ebartz/esp8266-rfid-sonos/img/001.jpg

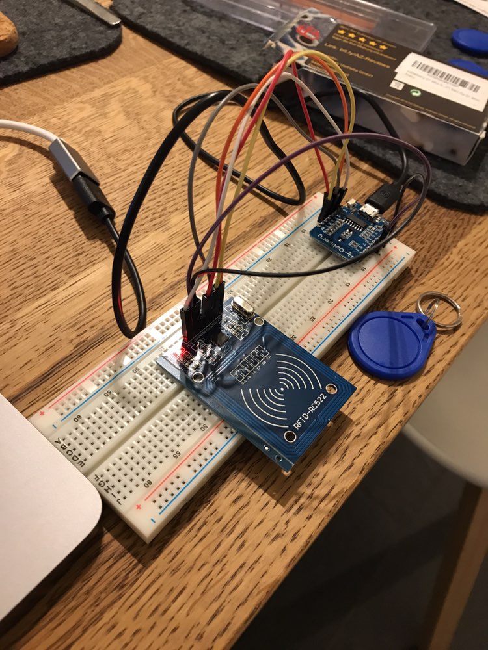
img/001.jpg
